NicholasGBlanchard/MotorizedFaderVCA/QuadMotorizedVCA/hardware/Front Panel/FrontPanelRender.PNG

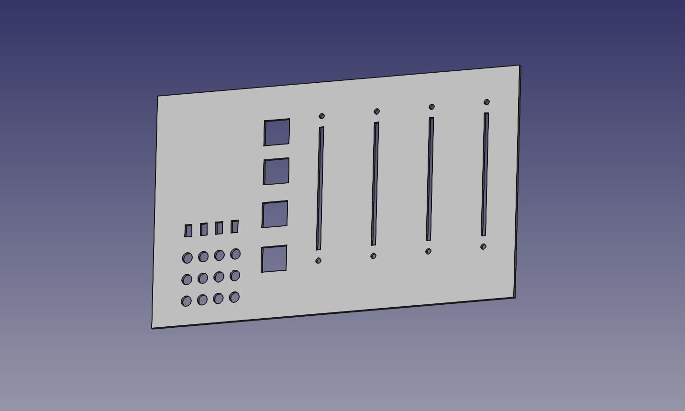
QuadMotorizedVCA/hardware/Front Panel/FrontPanelRender.PNG
