NicholasGBlanchard/MotorizedFaderVCA/QuadMotorizedVCA/hardware/Front Panel/FrontPanel-BodyPadFinal.obj

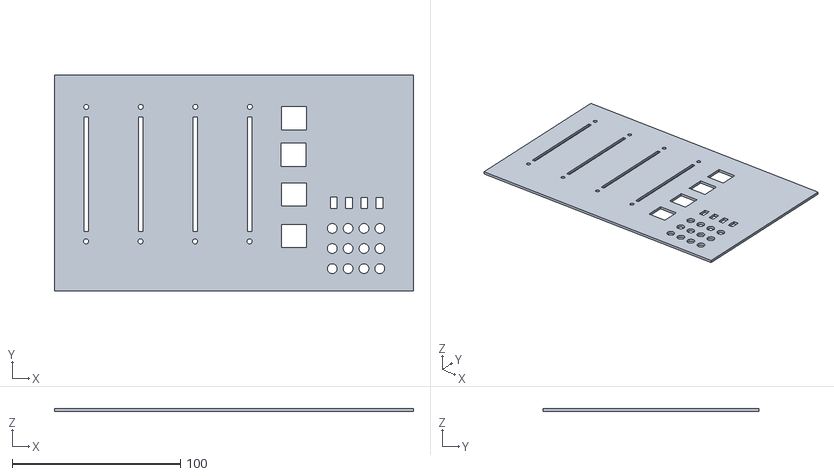
[picture p3: CAD file, 2022-05-04]
QuadMotorizedVCA/hardware/Front Panel/FrontPanel-BodyPadFinal.obj
213.4 x 128.5 x 1.85
