NicholasGBlanchard/MotorizedFaderVCA/QuadMotorizedVCA/hardware/Front Panel/FrontPanel-BodyPad.obj

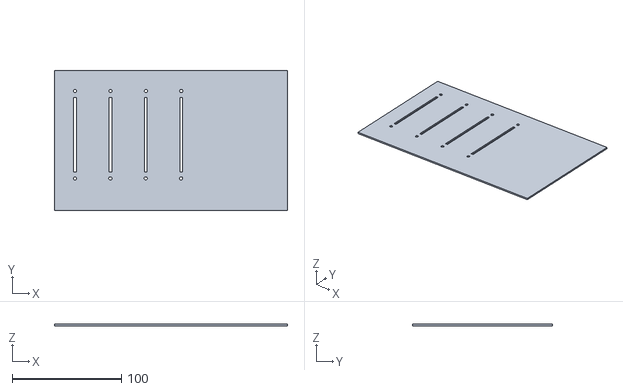
[picture p4: CAD file, 2022-05-04]
QuadMotorizedVCA/hardware/Front Panel/FrontPanel-BodyPad.obj
213.4 x 128.5 x 1.52
