NicholasGBlanchard/MotorizedFaderVCA/(list of files, cad)

Other CAD files:
QuadMotorizedVCA/hardware/Front Panel/FrontPanel.FCStd
