NicholasGBlanchard/MotorizedFaderVCA/QuadMotorizedVCA/hardware/Schematic/ArduinoDueShieldVersion/Schematic_Quad vca motor driver_Arduino_Due_Sheild.pdf

Driver Cluster 1 | Driver Cluster 2

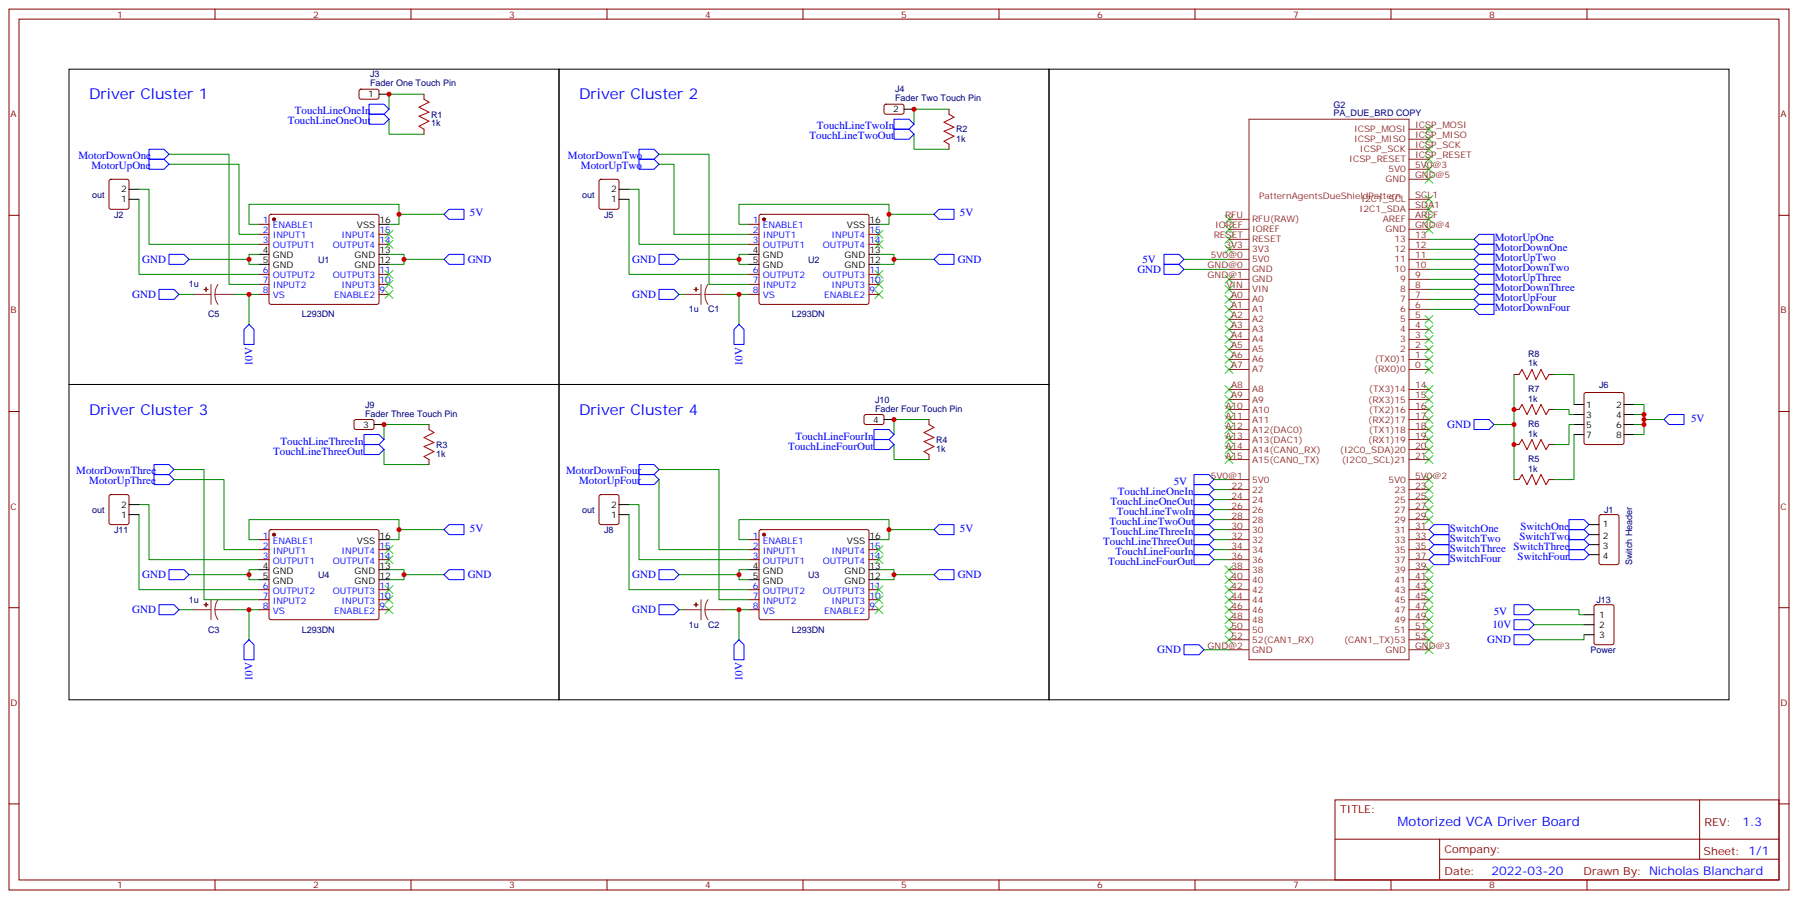
[picture p5: page 1]
