NicholasGBlanchard/MotorizedFaderVCA/QuadMotorizedVCA/hardware/Schematic/UniversalVersion/Schematic_MotorizedFaderVCA_Universal_Version.pdf

## Driver Cluster 1

## Driver Cluster 1

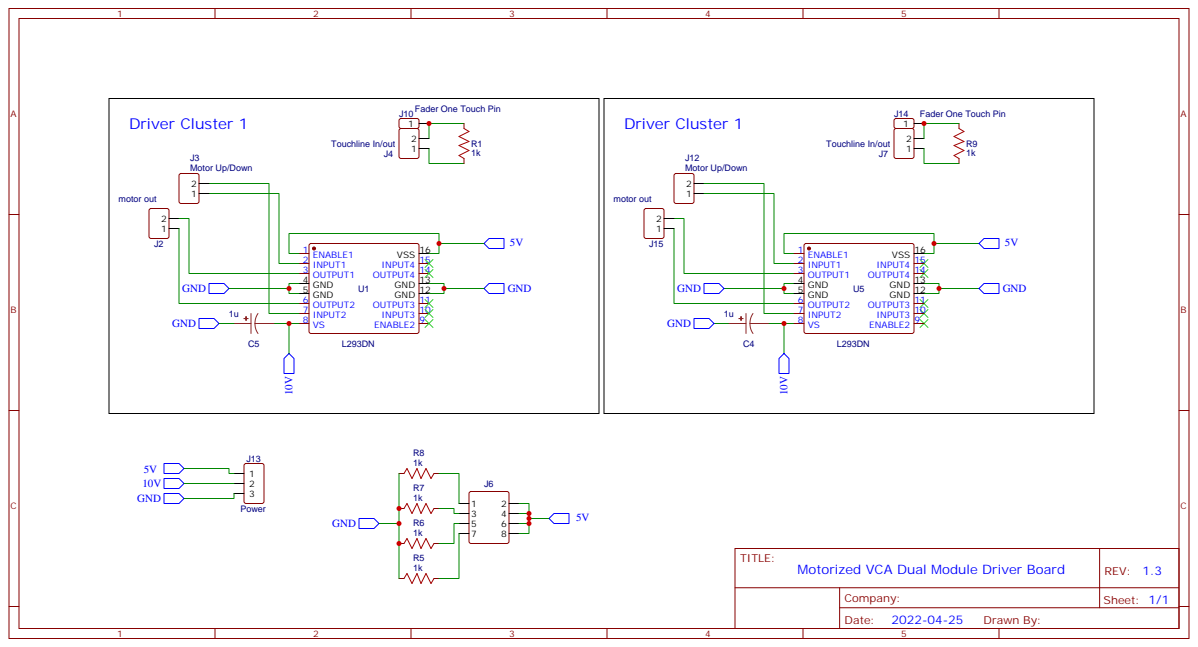
[picture p6: page 1]
