NicholasGBlanchard/MotorizedFaderVCA/QuadMotorizedVCA/hardware/PCB/ArduinoDueSheildVersion/PCB_MotorizedFaderVCA_Arduino_Due_Sheild.pdf

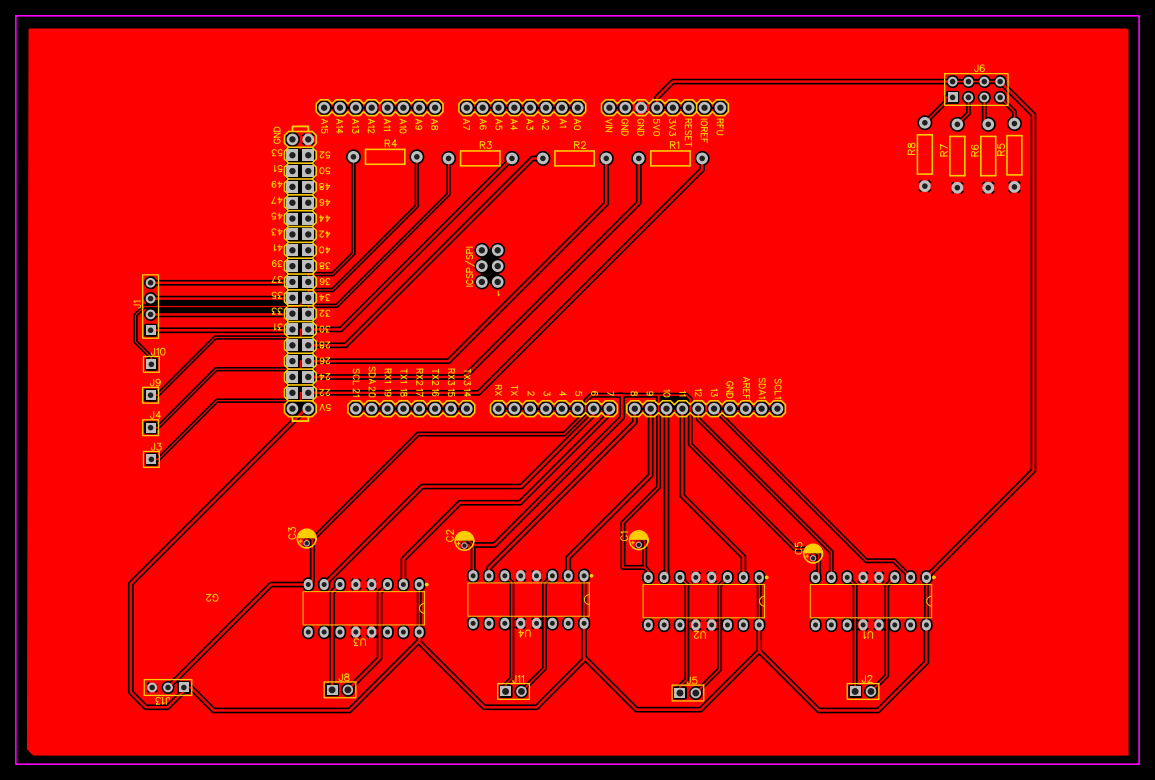
[picture p7: page 1]
