NicholasGBlanchard/MotorizedFaderVCA/QuadMotorizedVCA/hardware/PCB/UniversalVersion/PCB_MotorizedFaderVCA_Universal_Version.pdf

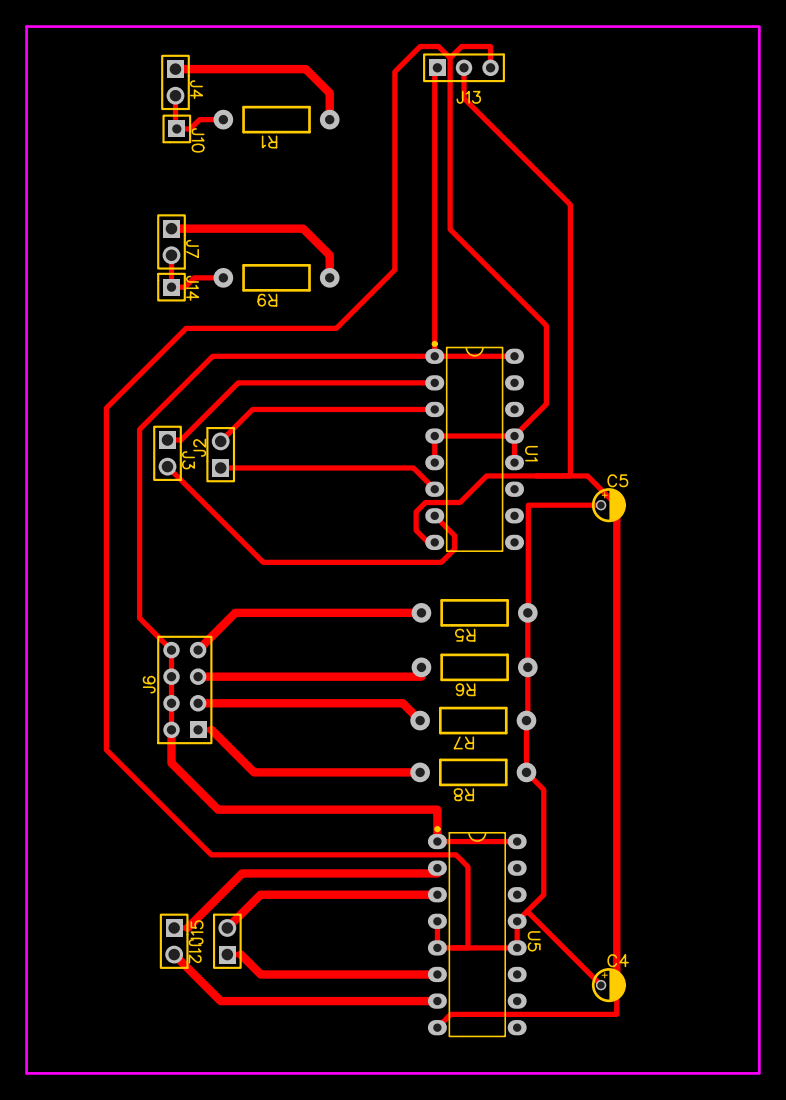
[picture p8: page 1]
