NicholasGBlanchard/MotorizedFaderVCA/QuadMotorizedVCA/hardware/GerberFiles/arduinoDueVersionPCB/Gerber_PCB_MotorizedFaderVCA1/How-to-order-PCB.txt

How to Order PCB

Please refer to:
https://docs.easyeda.com/en/PCB/Order-PCB
