NicholasGBlanchard/MotorizedFaderVCA/QuadMotorizedVCA/design_test_plan/Project Test Plan.xlsx

Sheet: Systems Test Cases
Date | Test Case ID | Description | Expected Results | Tester Name | Pass/Fail | Fix Date
2022-04-25 | 1 | EEPROM function | Memory address that is allocated for recording faders 1-4 position and data stored there should remain consistent after shutdown | Nicholas Blanchard | Pass
2022-04-25 | 2 | Button Press function | Serial moniter data test should demonstrate fast response time for detecting button presses, either long or short | Nicholas Blanchard | Pass
2022-04-25 | 3 | Stepper Driver/Hbridge Function | Values being sent to the driver from the MCU should have an ultra low ms latency | Nicholas Blanchard | Pass
2022-04-25 | 4 | Scalable Sinusoidal Function | Error free user input for the alteration of speed of the sinusoidal animation of the motorized fader easter egg feature | Nicholas Blanchard | Fail | Fixing not achievable in allocated time
2022-04-25 | 5 | EEPROM Recall Function | Write and recall of presets while powered on. | Nicholas Blanchard | Pass
2022-04-25 | 6 | Capacitive Touch Function | Reading of positional value is active when fader is touched. | Nicholas Blanchard | Pass

Sheet: Unit Test Cases
Date | Test Case ID | Description | Expected Results | Tester Name | Pass/Fail | Fix Date
2022-04-25 | 1 | Saving Pot Position to EEPROM | For each of the four “saved state” slots (one per button) the unit should be able to write and read those states from their address in the EEPROM | Nicholas Blanchard | Pass
2022-04-25 | 2 | Button Press Functionality | Buttons 1-4 short press should result in the corresponding saved state being recalled. Buttons 1-4 when long pressed (3 sec) should result in current position of fader/pot being saved to corresponding slot. Long press of buttons 1 and 4 (5 sec) results in a sinusoidal pattern of movement actuated by faders. | Nicholas Blanchard | Pass
2022-04-25 | 3 | Motor Stepper Driver Smoothing/PID Tuning | Values being sent to the motor driver hbridge IC should be tuned for smoothness. | Nicholas Blanchard | Pass
2022-04-25 | 4 | Hidden Function (Sinusoidal motor movement) | the calculated set of values should display and run smoothly for optimal sound quality for the amplifier | Nicholas Blanchard | Fail | Fix not within scope
2022-04-25 | 5 | Preset scrolling | Cycling through the four saved states should result in fast and accurate updating of the fader position | Nicholas Blanchard | Pass
2022-04-25 | 6 | Capacitive Touch | Signal is being received when fader is touched. | Nicholas Blanchard | Pass

Sheet: Mechanical Hardware Test Cases
Date | Test Case ID | Description | Expected Results | Tester Name | Pass/Fail | Fix Date
2022-04-23 | 1 | Front Panel Fitment | All jacks, LED's, Potentiometers, faders, and buttons have no interference from the front panel when used | Nicholas Blanchard | Pass
2022-04-23 | 2 | Fader Sliding Clearance | Fader must have enough clearance on both the left and right side of the mechanical slider to accommodate for slider shaft wobble. | Nicholas Blanchard | Pass
2022-04-23 | 3 | Patch Cable Interference | When all 3.5mm patch points have a 3.5mm patch cable inserted the accessibility to the rest of the modules functions must not be hindered to allow for musical play-ability. | Nicholas Blanchard | Pass

Sheet: Motorized Potentiometer Breakou
Date | Test Case ID | Description | Expected Results | Tester Name | Pass/Fail | Fix Date
2022-04-17 | 1 | Buck Converter | Both current and voltage remains consistent over long periods of being powered on. | Nicholas Blanchard | Pass
2022-04-17 | 2 | Hbridge Current Draw Loaded/Unloaded | Current at 10v input is stable and consistant | Nicholas Blanchard | Pass
2022-04-17 | 3 | Motor Current Draw Loaded/Unloaded | Current at 10v input is stable and consistant | Nicholas Blanchard | Pass
2022-04-17 | 4 | Fader Capacitive Touch | Voltage going to capacitive touch input pin on fader and returning to MCU remains at rated amount | Nicholas Blanchard | Pass
2022-04-17 | 5 | Passive Component Stability | All passive components remain in working condition after a 10 hour period of unit being left on | Nicholas Blanchard | Pass

Sheet: Voltage Controlled Amplifier Ci
Date | Test Case ID | Description | Expected Results | Tester Name | Pass/Fail | Fix Date
2022-04-02 | 1 | Power Section | Testing with multimeter should yield rated voltages and their currents to be within error margin range | Nicholas Blanchard | Pass
2022-04-02 | 2 | VCA 1 | Audio input and modulation input accepting signal. Audio output should be outputting signal for rated dB level. | Nicholas Blanchard | Pass
2022-04-02 | 3 | VCA 2 | Audio input and modulation input accepting signal. Audio output should be outputting signal for rated dB level. | Nicholas Blanchard | Pass
2022-04-02 | 4 | VCA 3 | Audio input and modulation input accepting signal. Audio output should be outputting signal for rated dB level. | Nicholas Blanchard | Pass
2022-04-02 | 5 | VCA 4 | Audio input and modulation input accepting signal. Audio output should be outputting signal for rated dB level. | Nicholas Blanchard | Pass
2022-04-02 | 6 | Attenuators | The attenuation circuit for adding or subtracting amplitude to the modulation source signal that is being input should, for all four individual VCA’s attenuate equally | Nicholas Blanchard | Pass
