NicholasGBlanchard/MotorizedFaderVCA/QuadMotorizedVCA/photos/EtchingTwo.JPG

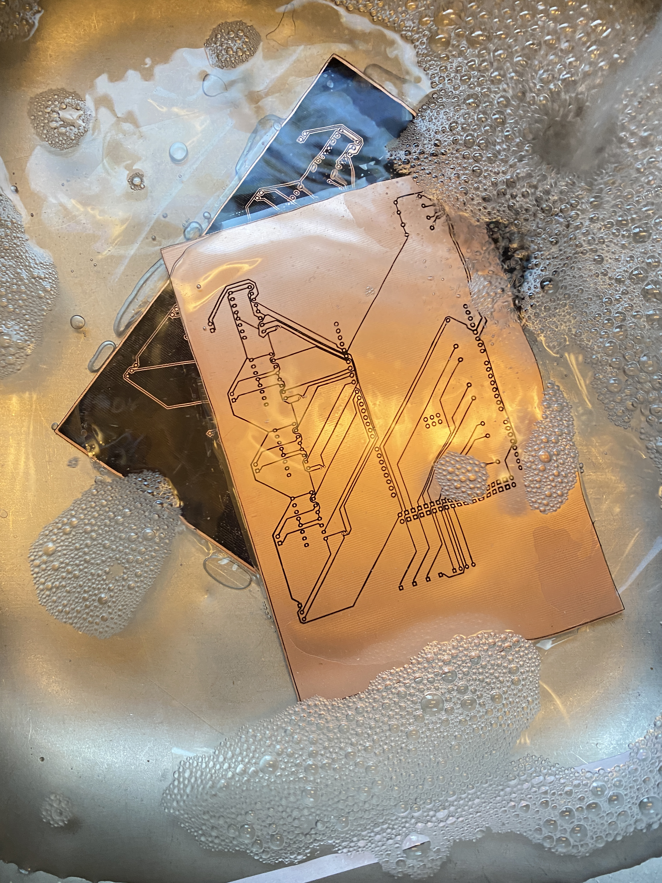
QuadMotorizedVCA/photos/EtchingTwo.JPG
